russdill/pmc-17/output/pmc_back.png

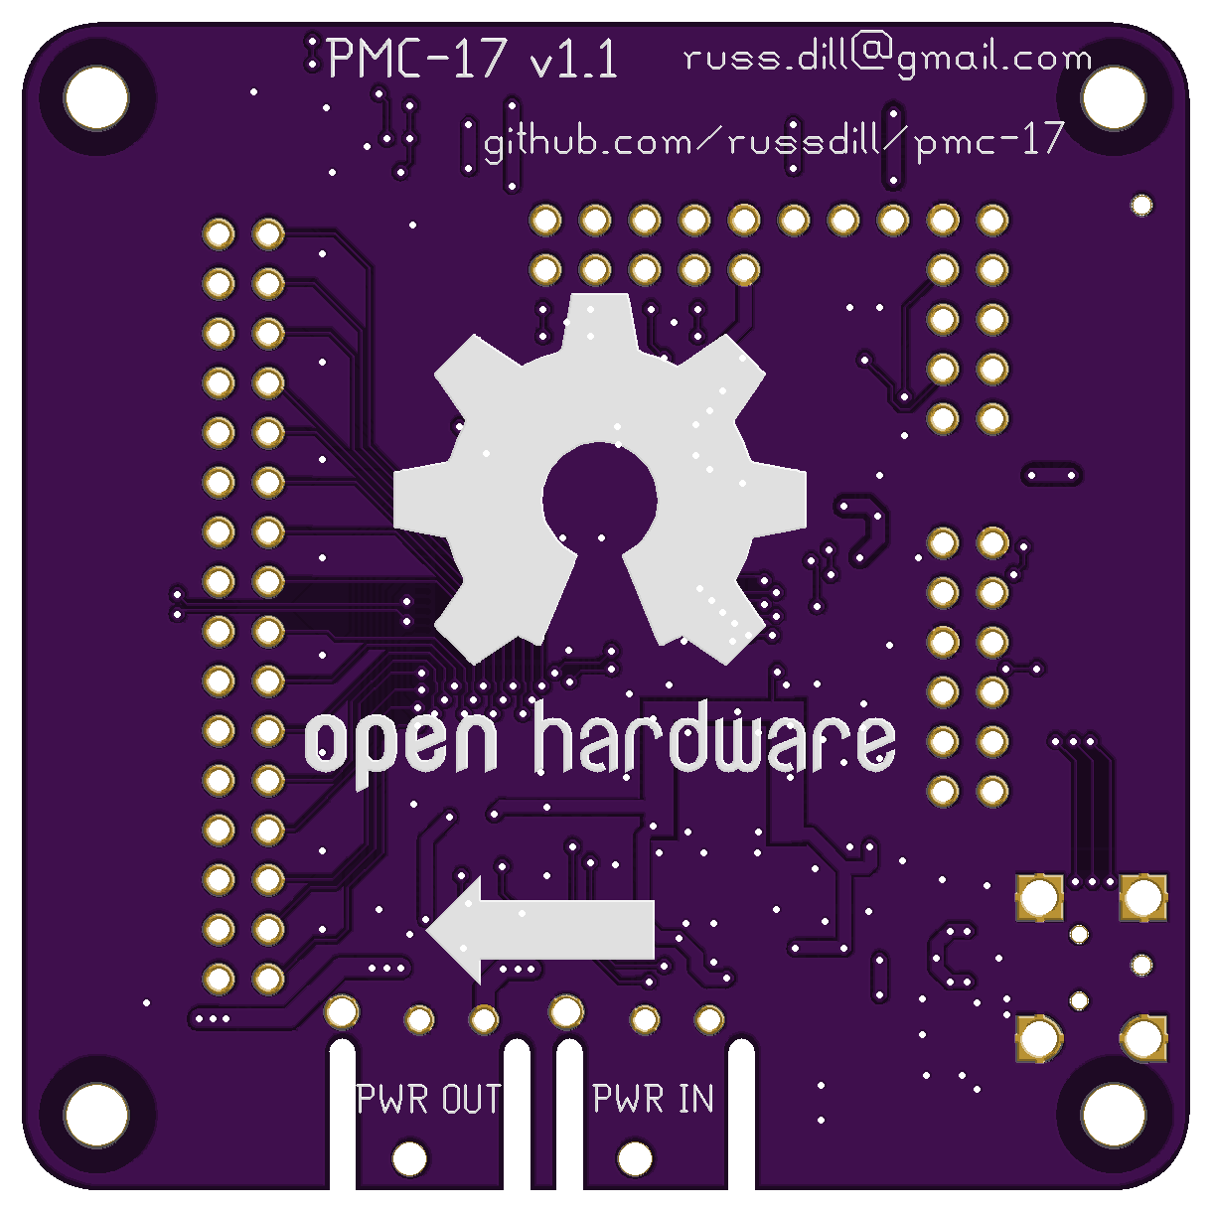
output/pmc_back.png
