russdill/pmc-17/output/pmc_front.png

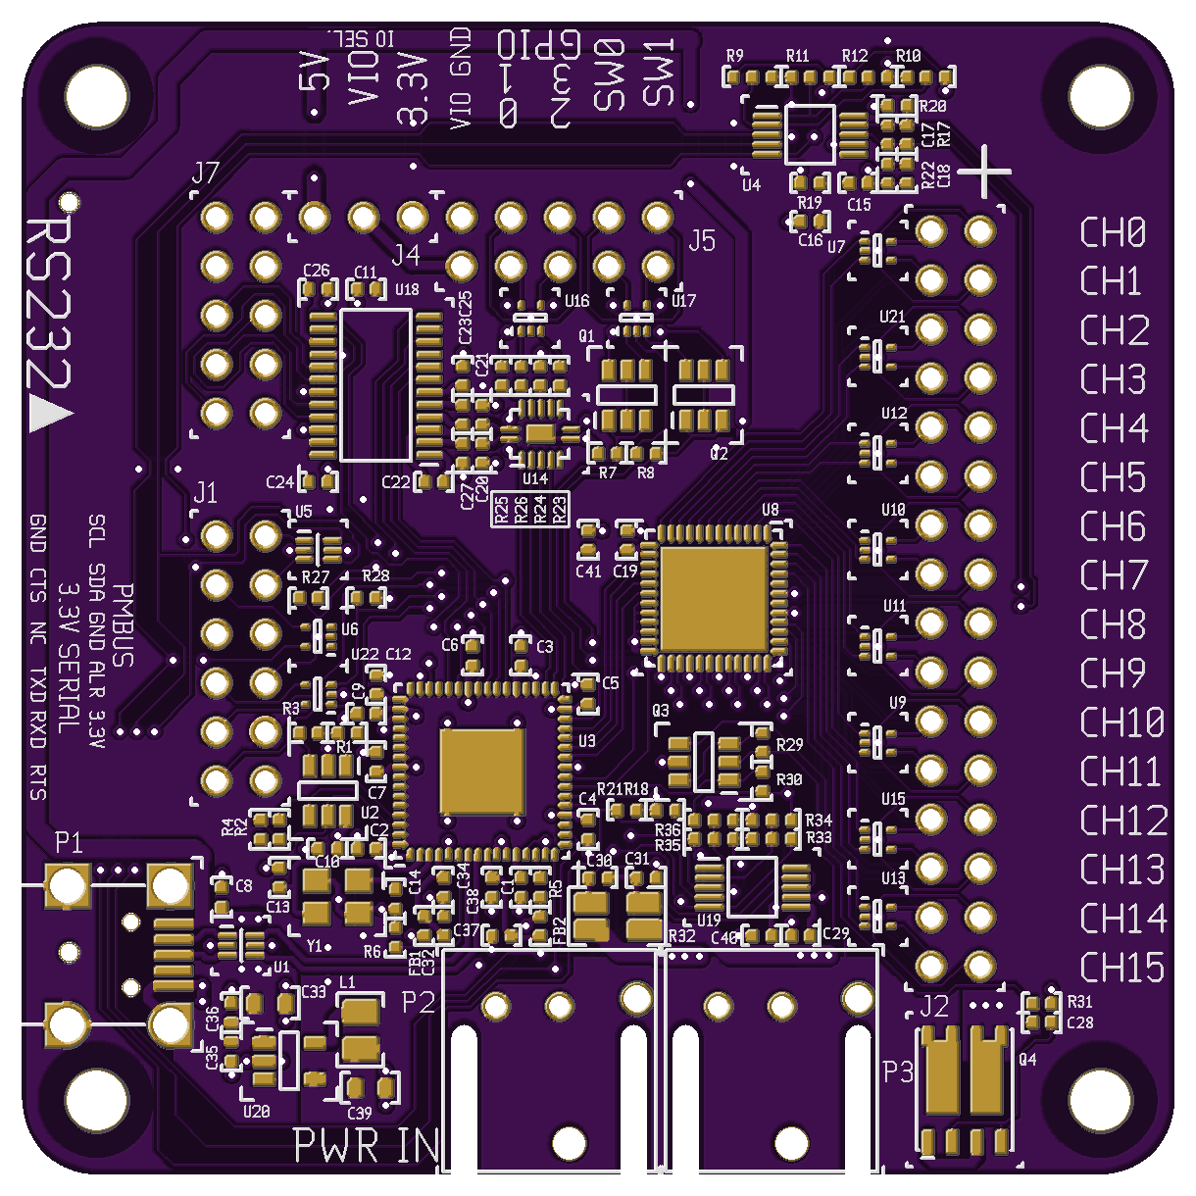
output/pmc_front.png
