russdill/pmc-17/output/pmc.pdf

# pmc.pcb

# 1. Table of Contents (This Page) Created on Fri Sep 27 02:22:39 2013

# 2. top 3. bottom 4. outline 5. plated-drill 6. unplated-drill 7. componentmask 8. soldermask 9. topsilk 10. bottomsilk 11. toppaste 12. topassembly 13. bottomassembly 14. fab

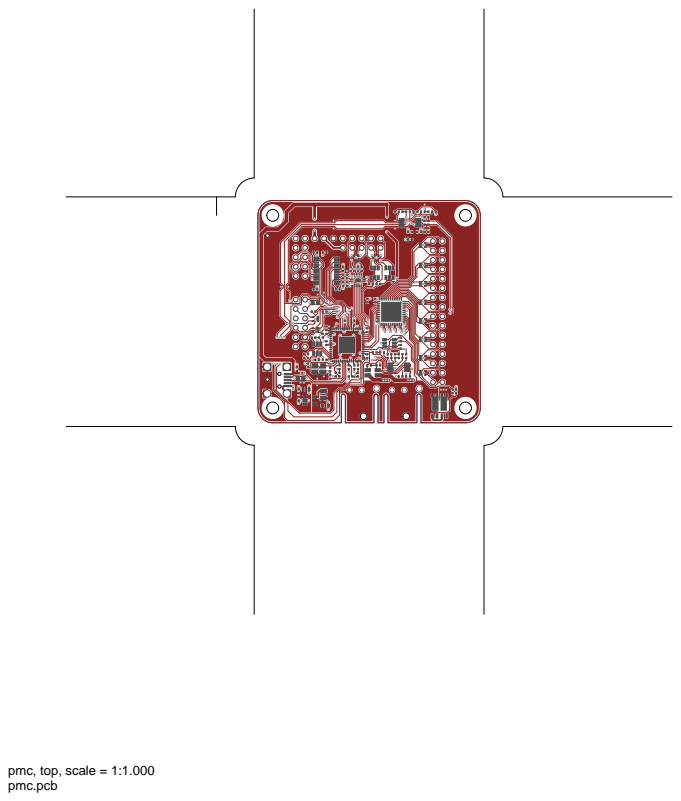
[picture p10: page 2]

pmc, top, scale = 1:1.000

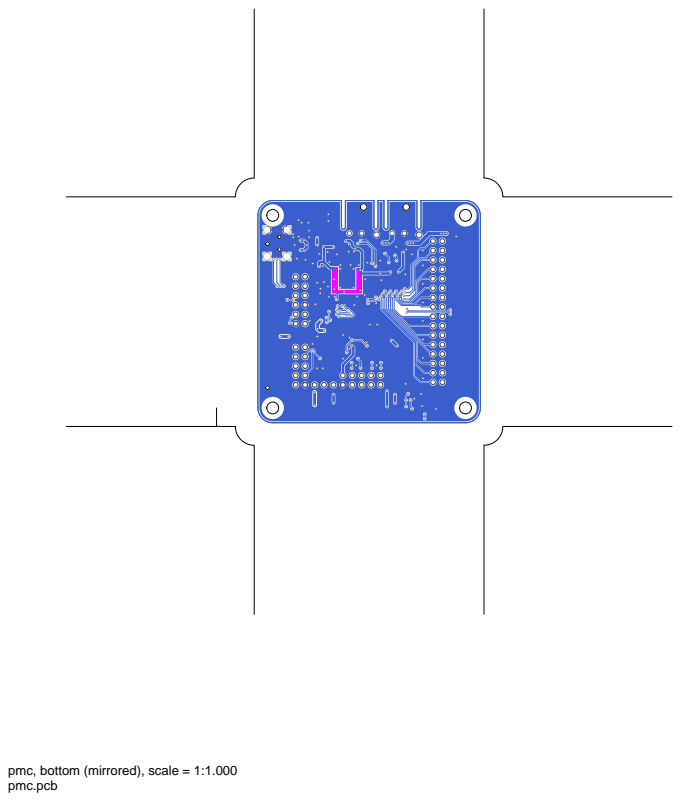
[picture p11: page 3]

pmc, bottom (mirrored), scale = 1:1.000

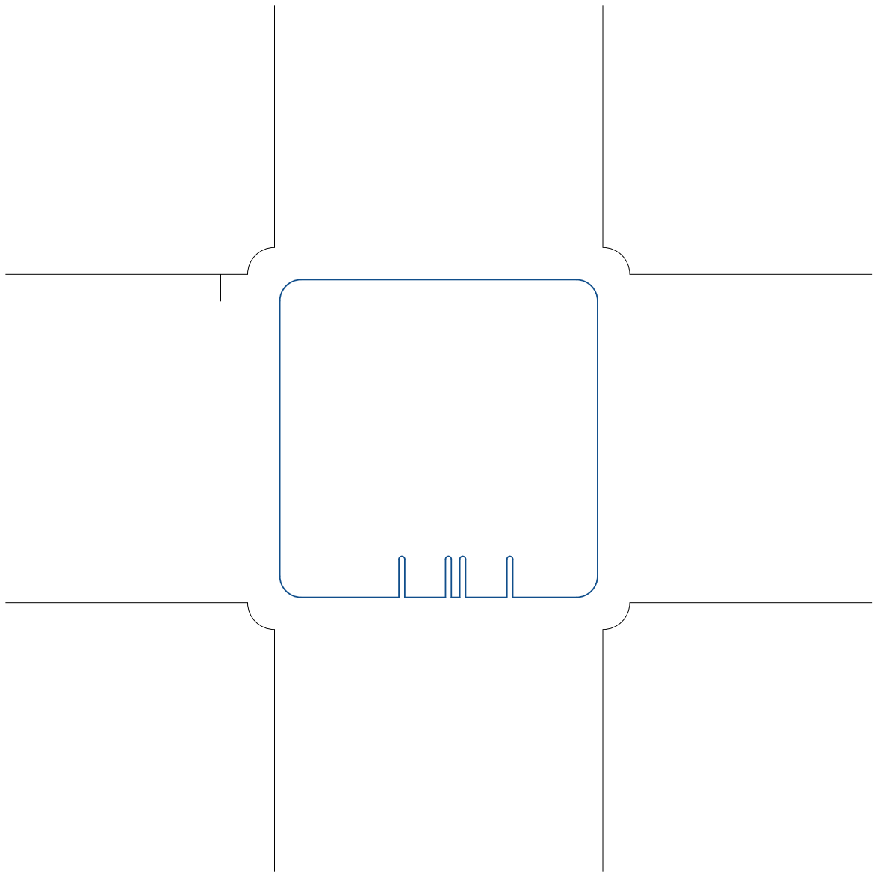
[picture p12: figure]

pmc, outline, scale = 1:1.000

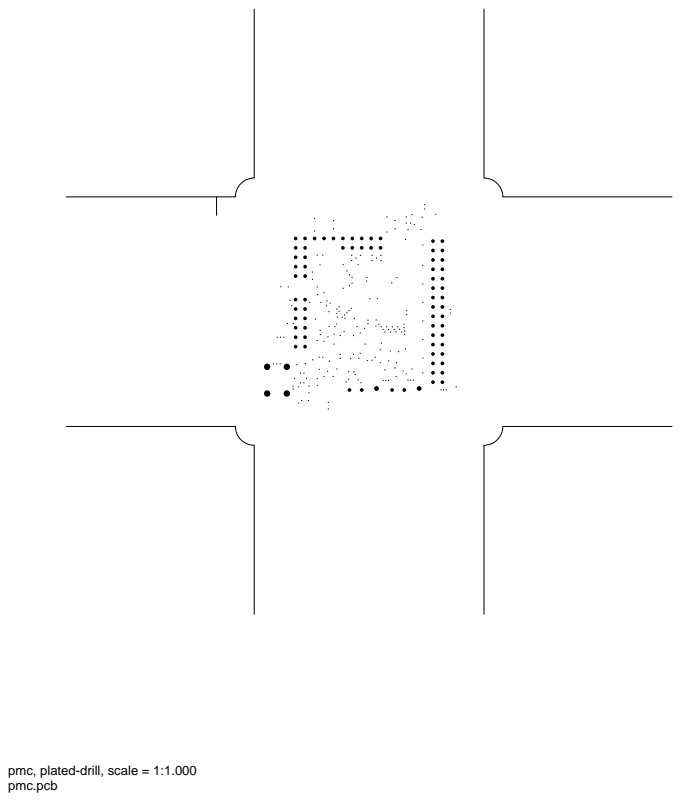
[picture p13: page 5]

pmc, plated-drill, scale = 1:1.000

pmc, unplated-drill, scale = 1:1.000

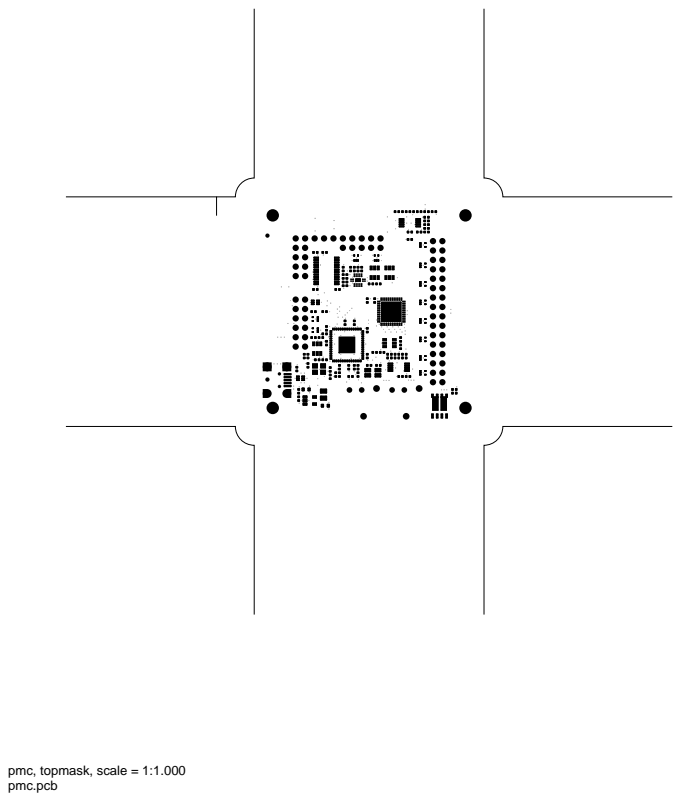
[picture p14: page 7]

pmc, topmask, scale = 1:1.000

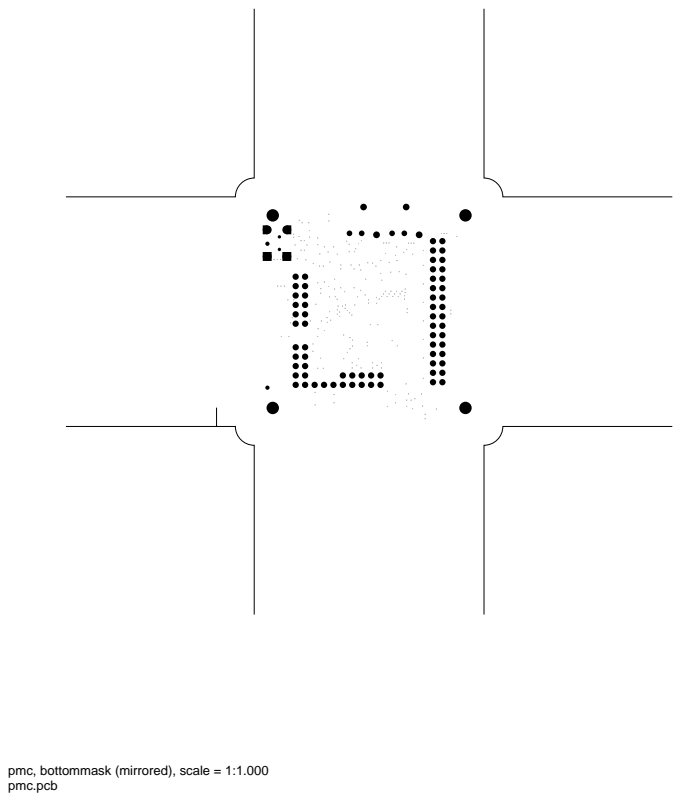
[picture p15: page 8]

pmc, bottommask (mirrored), scale = 1:1.000

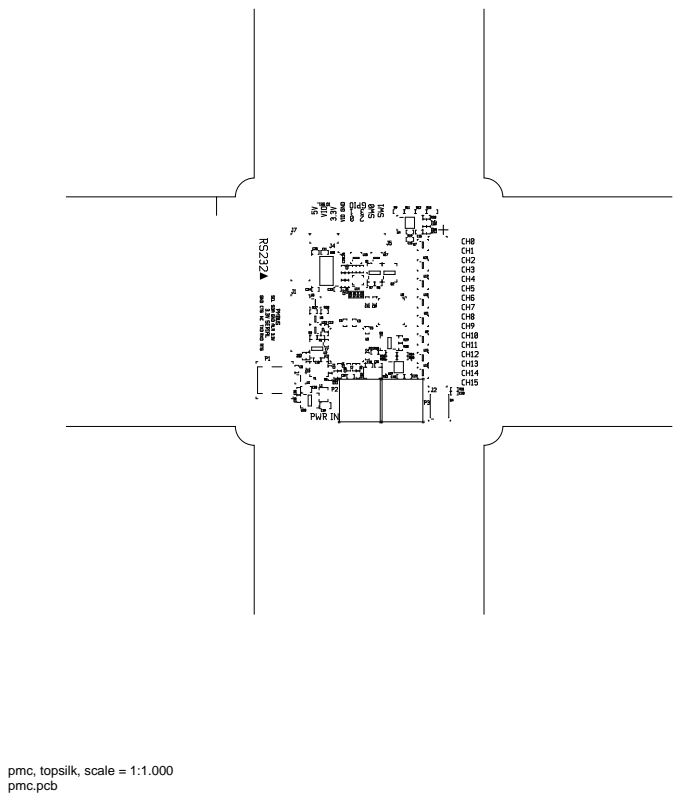
[picture p16: page 9]

pmc, topsilk, scale = 1:1.000

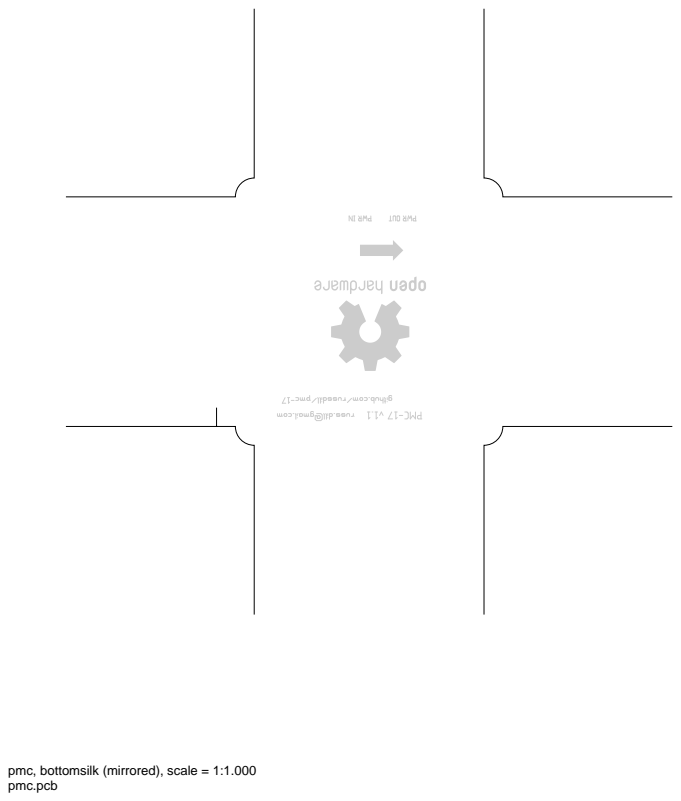
[picture p17: page 10]

pmc, bottomsilk (mirrored), scale = 1:1.000

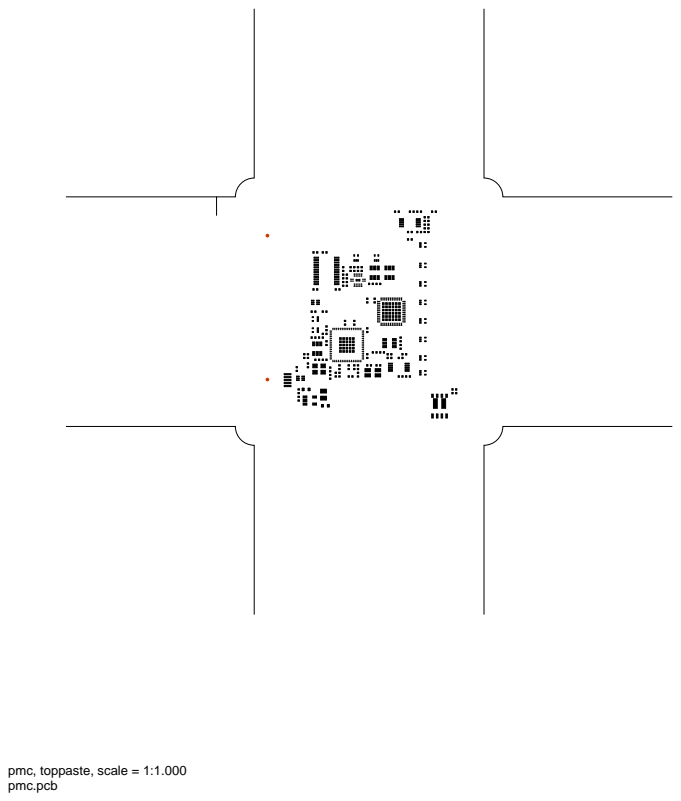
[picture p18: page 11]

pmc, toppaste, scale = 1:1.000

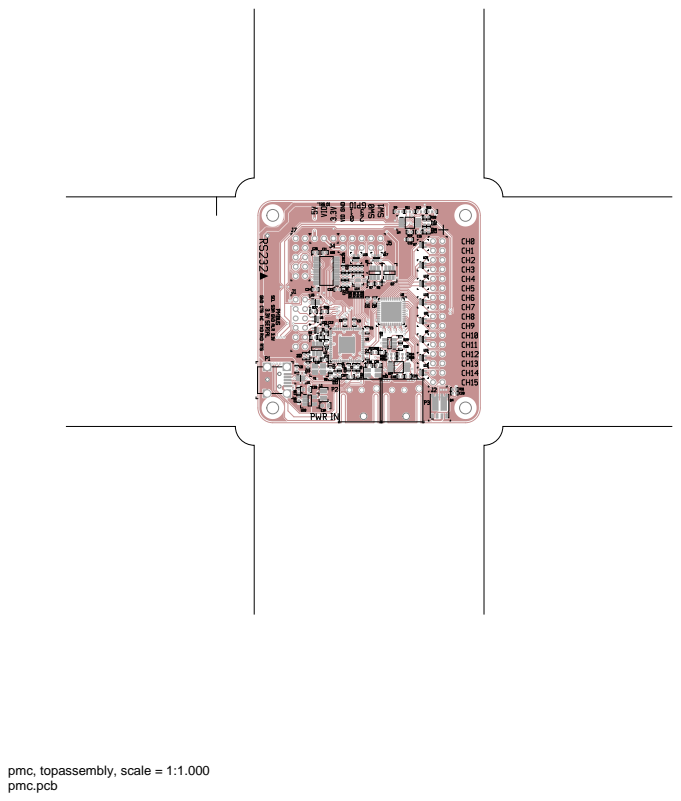
[picture p19: page 12]

pmc, topassembly, scale = 1:1.000

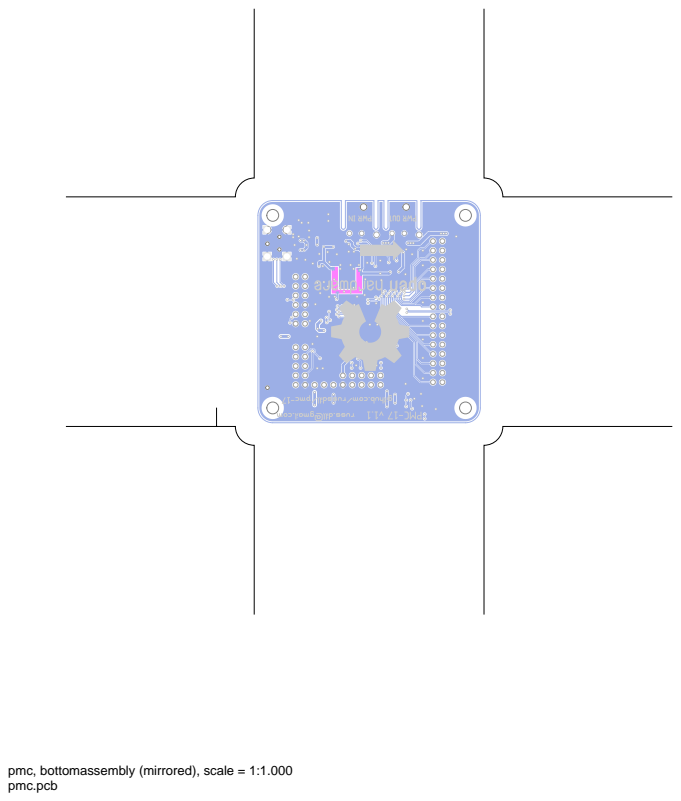
[picture p20: page 13]

pmc, bottomassembly (mirrored), scale = 1:1.000

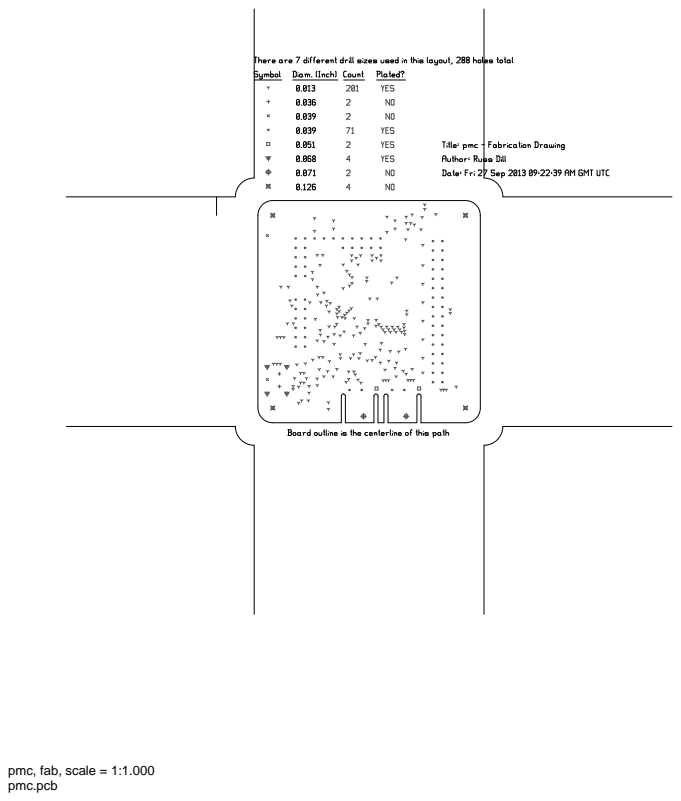
[picture p21: page 14]

pmc, fab, scale = 1:1.000
