russdill/pmc-17/(list of files, drawings)

Other design files:
pmc.pcb
