russdill/pmc-17/(commit log)

2013-09-20 v1.0 Fixes
    - Address selection of INA226's was incorrect, fixed by
    simply moving 0 ohm resistors
    - Instead of putting resistors in series with rs232 level translation
    chip, they were put in series with the ttl connector. The resistors
    should provide the device connected on the ttl connector to out
    drive the level translation chip. Fix is to replace the resistors with
    zero ohm resistors, and place them instead between the pad
    and pin on the level translation chip.
    [pmc_2.sch, pmc_5.sch, pmc_6.sch]
2013-09-23 Note reversed GPIO naming
    [pmc_4.sch]
2013-09-26 Update mosfets to proper component name
2013-09-26 Remove partno that wasn't supposed to be in the schematic
    Don't really need em for passives.
    [pmc_1.sch]
2013-09-26 Bump up series resistors for rs232 to 1k
    100 ohm wasn't attenuating the signals from the transceiver enough. 1k
    is plenty and the transceiver still communicates succesfully with the FTDI
    [pmc_5.sch]
2013-09-27 Apply corrections from v1.0 to schematic and pcb to make v1.1
    [pmc.pcb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]
